jp112sdl/LAWO-FlipDot/PCB/BROSE_LAWO_Adapter/BROSE_LAWO_Adapter.kicad_sch

## KiCad design PCB/BROSE_LAWO_Adapter/BROSE_LAWO_Adapter.kicad_sch (2026-02-11)

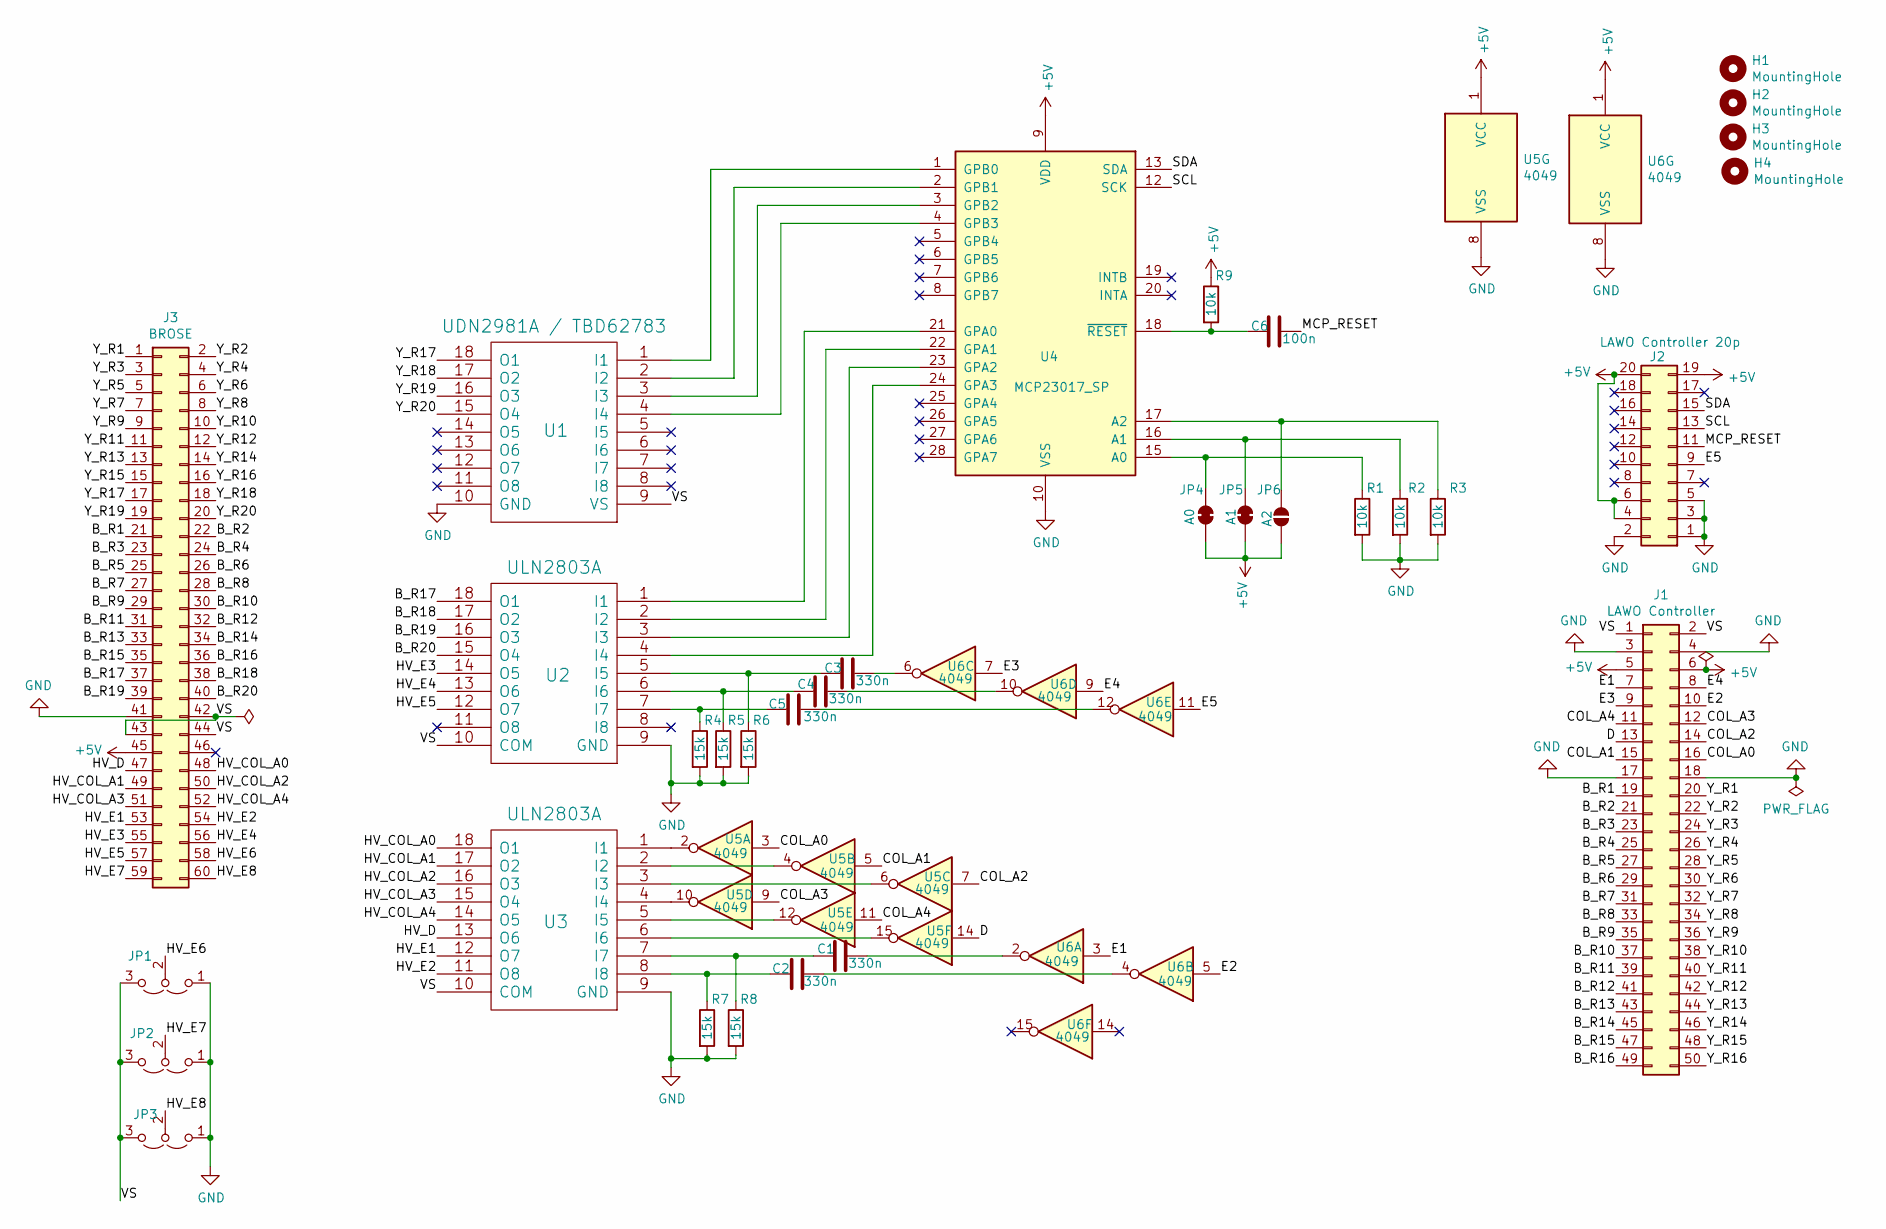
[picture p1: schematic BROSE_LAWO_Adapter.kicad_sch]

Parts:
C1, C2, C3, C4, C5: 330n; C_Rect_L10.0mm_W4.0mm_P7.50mm_MKS4
C6: 100n; C_0805_2012Metric_Pad1.15x1.40mm_HandSolder
H1, H2, H3, H4: MountingHole; 1pin
J1: LAWO Controller; IDC-Header_2x25_P2.54mm_Vertical
J2: LAWO Controller 20p; IDC-Header_2x10_P2.54mm_Vertical
J3: BROSE; IDC-Header_2x30_P2.54mm_Vertical
JP1: E6; PinHeader_1x03_P2.54mm_Vertical
JP2: E7; PinHeader_1x03_P2.54mm_Vertical
JP3: E8; PinHeader_1x03_P2.54mm_Vertical
JP4: A0; SolderJumper-2_P1.3mm_Bridged_RoundedPad1.0x1.5mm
JP5: A1; SolderJumper-2_P1.3mm_Bridged_RoundedPad1.0x1.5mm
JP6: A2; SolderJumper-2_P1.3mm_Open_RoundedPad1.0x1.5mm
R1, R2, R3, R9: 10k; R_0805_2012Metric_Pad1.15x1.40mm_HandSolder
R4, R5, R6, R7, R8: 15k; R_Axial_DIN0204_L3.6mm_D1.6mm_P2.54mm_Vertical
U1: UDN2981A / TBD62783; DIP-18_W7.62mm_Socket
U2, U3: ULN2803A; DIP-18_W7.62mm_Socket
U4: MCP23017_SP; DIP-28_W7.62mm_Socket
U5, U6: 4049; DIP-16_W7.62mm_Socket

Connections:
+5V: J1.5, J1.6, J2.4, J2.6, J2.19, J2.20, J3.45, JP4.2 (B), JP5.2 (B), JP6.2 (B), R9.1, U4.9 (VDD), U5.1 (VCC), U6.1 (VCC)
B_R1: J1.19, J3.21
B_R2: J1.21, J3.22
B_R3: J1.23, J3.23
B_R4: J1.25, J3.24
B_R5: J1.27, J3.25
B_R6: J1.29, J3.26
B_R7: J1.31, J3.27
B_R8: J1.33, J3.28
B_R9: J1.35, J3.29
B_R10: J1.37, J3.30
B_R11: J1.39, J3.31
B_R12: J1.41, J3.32
B_R13: J1.43, J3.33
B_R14: J1.45, J3.34
B_R15: J1.47, J3.35
B_R16: J1.49, J3.36
B_R17: J3.37, U2.18 (O1)
B_R18: J3.38, U2.17 (O2)
B_R19: J3.39, U2.16 (O3)
B_R20: J3.40, U2.15 (O4)
COL_A0: J1.16, U5.3
COL_A1: J1.15, U5.5
COL_A2: J1.14, U5.7
COL_A3: J1.12, U5.9
COL_A4: J1.11, U5.11
D: J1.13, U5.14
E1: J1.7, U6.3
E2: J1.10, U6.5
E3: J1.9, U6.7
E4: J1.8, U6.9
E5: J2.9, U6.11
GND: J1.3, J1.4, J1.17, J1.18, J2.1, J2.2, J2.3, J2.5, J3.41, JP1.1 (A), JP2.1 (A), JP3.1 (A), R1.2, R2.2, R3.2, R4.2, R5.2, R6.2, R7.2, R8.2, U1.10 (GND), U2.9 (GND), U3.9 (GND), U4.10 (VSS), U5.8 (VSS), U6.8 (VSS)
HV_COL_A0: J3.48, U3.18 (O1)
HV_COL_A1: J3.49, U3.17 (O2)
HV_COL_A2: J3.50, U3.16 (O3)
HV_COL_A3: J3.51, U3.15 (O4)
HV_COL_A4: J3.52, U3.14 (O5)
HV_D: J3.47, U3.13 (O6)
HV_E1: J3.53, U3.12 (O7)
HV_E2: J3.54, U3.11 (O8)
HV_E3: J3.55, U2.14 (O5)
HV_E4: J3.56, U2.13 (O6)
HV_E5: J3.57, U2.12 (O7)
HV_E6: J3.58, JP1.2 (C)
HV_E7: J3.59, JP2.2 (C)
HV_E8: J3.60, JP3.2 (C)
MCP_RESET: C6.2, J2.11
unnamed: C1.1, R8.1, U3.7 (I7)
unnamed: C1.2, U6.2
unnamed: C2.1, R7.1, U3.8 (I8)
unnamed: C2.2, U6.4
unnamed: C3.1, R6.1, U2.5 (I5)
unnamed: C3.2, U6.6
unnamed: C4.1, R5.1, U2.6 (I6)
unnamed: C4.2, U6.10
unnamed: C5.1, R4.1, U2.7 (I7)
unnamed: C5.2, U6.12
unnamed: C6.1, R9.2, U4.18 (~RESET)
unnamed: JP4.1 (A), R1.1, U4.15 (A0)
unnamed: JP5.1 (A), R2.1, U4.16 (A1)
unnamed: JP6.1 (A), R3.1, U4.17 (A2)
unnamed: U1.1 (I1), U4.1 (GPB0)
unnamed: U1.2 (I2), U4.2 (GPB1)
unnamed: U1.3 (I3), U4.3 (GPB2)
unnamed: U1.4 (I4), U4.4 (GPB3)
unnamed: U2.1 (I1), U4.21 (GPA0)
unnamed: U2.2 (I2), U4.22 (GPA1)
unnamed: U2.3 (I3), U4.23 (GPA2)
unnamed: U2.4 (I4), U4.24 (GPA3)
unnamed: U3.1 (I1), U5.2
unnamed: U3.2 (I2), U5.4
unnamed: U3.3 (I3), U5.6
unnamed: U3.4 (I4), U5.10
unnamed: U3.5 (I5), U5.12
unnamed: U3.6 (I6), U5.15
SCL: J2.13, U4.12 (SCK)
SDA: J2.15, U4.13 (SDA)
VS: J1.1, J1.2, J3.42, J3.43, J3.44, JP1.3 (B), JP2.3 (B), JP3.3 (B), U1.9 (VS), U2.10 (COM), U3.10 (COM)
Y_R1: J1.20, J3.1
Y_R2: J1.22, J3.2
Y_R3: J1.24, J3.3
Y_R4: J1.26, J3.4
Y_R5: J1.28, J3.5
Y_R6: J1.30, J3.6
Y_R7: J1.32, J3.7
Y_R8: J1.34, J3.8
Y_R9: J1.36, J3.9
Y_R10: J1.38, J3.10
Y_R11: J1.40, J3.11
Y_R12: J1.42, J3.12
Y_R13: J1.44, J3.13
Y_R14: J1.46, J3.14
Y_R15: J1.48, J3.15
Y_R16: J1.50, J3.16
Y_R17: J3.17, U1.18 (O1)
Y_R18: J3.18, U1.17 (O2)
Y_R19: J3.19, U1.16 (O3)
Y_R20: J3.20, U1.15 (O4)
