jp112sdl/LAWO-FlipDot/PCB/LAWO_ESP32/LAWO_ESP32.kicad_sch

## KiCad design PCB/LAWO_ESP32/LAWO_ESP32.kicad_sch (2026-02-11)

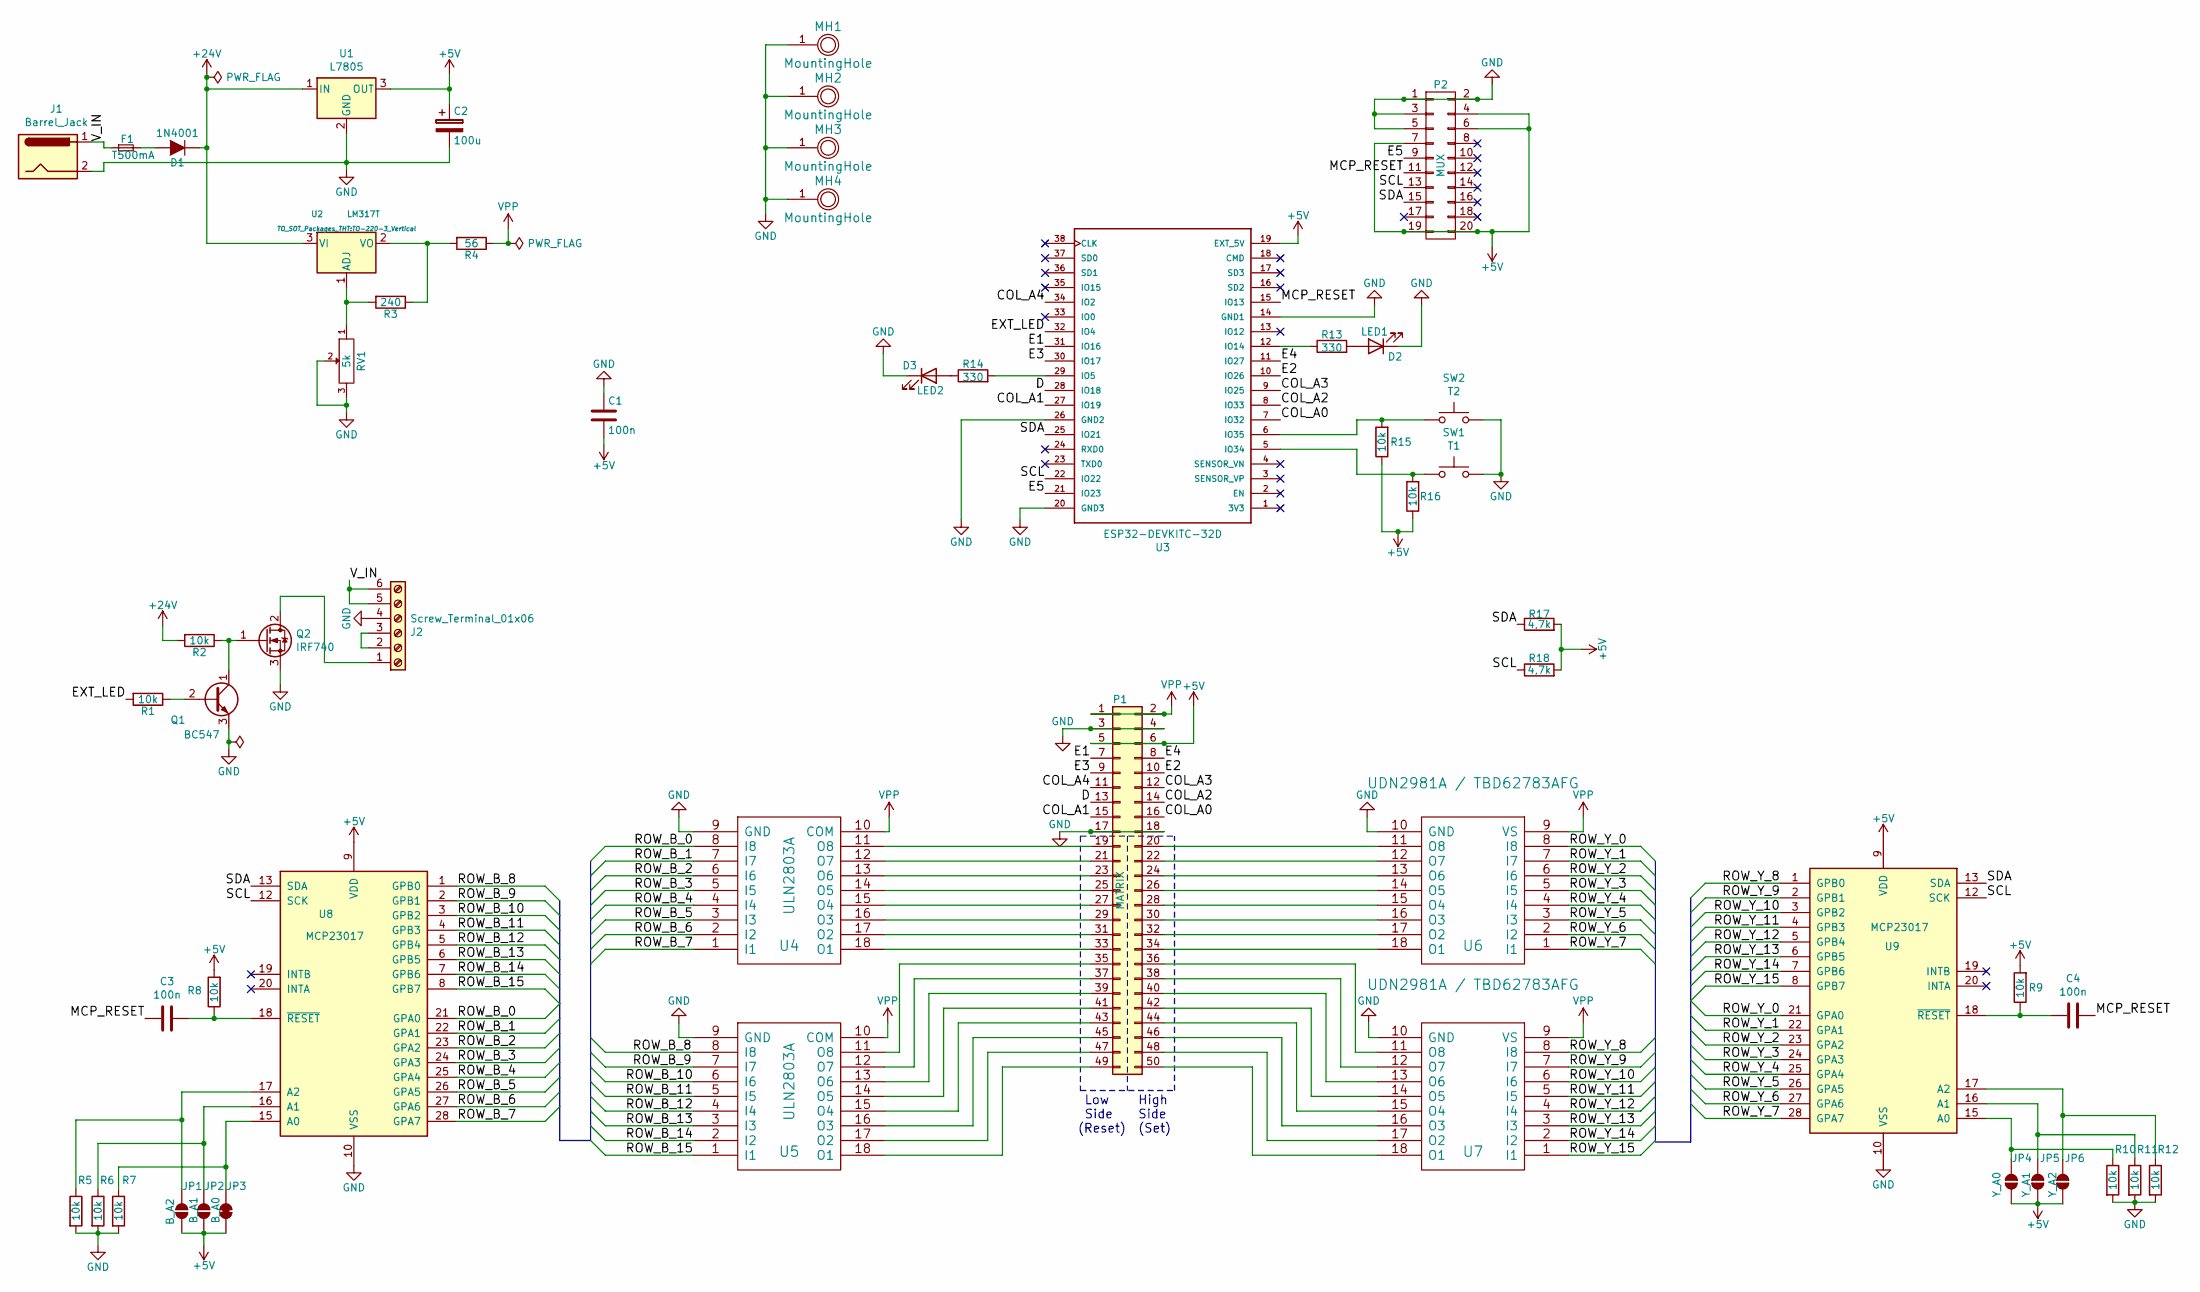
[picture p2: schematic LAWO_ESP32.kicad_sch]

Parts:
C1, C3, C4: 100n; C_0805_2012Metric_Pad1.15x1.40mm_HandSolder
C2: 100u; CP_Radial_D5.0mm_P2.00mm
D1: 1N4001; D_DO-41_SOD81_P10.16mm_Horizontal
D2: LED1; LED_D3.0mm
D3: LED2; LED_D3.0mm
F1: T500mA; Fuseholder5x20_horiz_open_Schurter_0031_8201
J1: Barrel_Jack; BARREL_JACK
J2: Screw_Terminal_01x06; TerminalBlock_bornier-6_P5.08mm
JP1: B_A2; SolderJumper-2_P1.3mm_Open_RoundedPad1.0x1.5mm
JP2: B_A1; SolderJumper-2_P1.3mm_Open_RoundedPad1.0x1.5mm
JP3: B_A0; SolderJumper-2_P1.3mm_Bridged2Bar_RoundedPad1.0x1.5mm
JP4: Y_A0; SolderJumper-2_P1.3mm_Open_RoundedPad1.0x1.5mm
JP5: Y_A1; SolderJumper-2_P1.3mm_Open_RoundedPad1.0x1.5mm
JP6: Y_A2; SolderJumper-2_P1.3mm_Open_RoundedPad1.0x1.5mm
MH1, MH2, MH3, MH4: MountingHole; 1pin
P1: MATRIX; IDC_Header_Straight_50pins
P2: MUX; IDC_Header_Straight_20pins
Q1: BC547; TO-92_HandSolder
Q2: IRF740; TO-220-3_Vertical
R1, R2, R5, R6, R7, R8, R9, R10, R11, R12, R15, R16: 10k; R_0805_2012Metric
R3: 240; R_0805_2012Metric
R4: 56; R_Axial_DIN0411_L9.9mm_D3.6mm_P15.24mm_Horizontal
R13, R14: 330; R_0805_2012Metric
R17, R18: 4,7k; R_0805_2012Metric
RV1: 5k; Potentiometer_Trimmer_Bourns_3299W
SW1: T1; SW_PUSH_6mm_h5mm
SW2: T2; SW_PUSH_6mm_h5mm
U1: L7805; SIP3_11.6x8.5mm
U2: LM317T; TO-220-3_Vertical
U3: ESP32-DEVKITC-32D; MODULE_ESP32-DEVKITC-32D
U4, U5: ULN2803A; DIP-18_W7.62mm_Socket
U6, U7: UDN2981A / TBD62783AFG; DIP-18_W7.62mm_Socket
U8, U9: MCP23017; DIP-28_W7.62mm_Socket

Connections:
+5V: C1.2, C2.1, JP1.2 (B), JP2.2 (B), JP3.2 (B), JP4.2 (B), JP5.2 (B), JP6.2 (B), P1.5, P1.6, P2.4, P2.6, P2.7, P2.19, P2.20, R8.2, R9.2, R15.1, R16.1, R17.2, R18.2, U1.3 (OUT), U3.19 (EXT_5V), U8.9 (VDD), U9.9 (VDD)
+24V: D1.1 (K), R2.2, U1.1 (IN), U2.3 (VI)
COL_A0: P1.16, U3.7 (IO32)
COL_A1: P1.15, U3.27 (IO19)
COL_A2: P1.14, U3.8 (IO33)
COL_A3: P1.12, U3.9 (IO25)
COL_A4: P1.11, U3.34 (IO2)
D: P1.13, U3.28 (IO18)
E1: P1.7, U3.31 (IO16)
E2: P1.10, U3.10 (IO26)
E3: P1.9, U3.30 (IO17)
E4: P1.8, U3.11 (IO27)
E5: P2.9, U3.21 (IO23)
EXT_LED: R1.2, U3.32 (IO4)
GND: C1.1, C2.2, D2.1 (K), D3.1 (K), J1.2, J2.4, MH1.1, MH2.1, MH3.1, MH4.1, P1.3, P1.4, P1.17, P1.18, P2.1, P2.2, P2.3, P2.5, Q1.3 (E), Q2.3 (S), R5.2, R6.2, R7.2, R10.2, R11.2, R12.2, RV1.2, RV1.3, SW1.2, SW2.2, U1.2 (GND), U3.14 (GND1), U3.20 (GND3), U3.26 (GND2), U4.9 (GND), U5.9 (GND), U6.10 (GND), U7.10 (GND), U8.10 (VSS), U9.10 (VSS)
MCP_RESET: C3.2, C4.1, P2.11, U3.15 (IO13)
unnamed: C3.1, R8.1, U8.18 (~RESET)
unnamed: C4.2, R9.1, U9.18 (~RESET)
unnamed: D1.2 (A), F1.2
unnamed: D2.2 (A), R13.2
unnamed: D3.2 (A), R14.1
unnamed: J2.1, Q2.2 (D)
unnamed: J2.2, J2.3
unnamed: JP1.1 (A), R5.1, U8.17 (A2)
unnamed: JP2.1 (A), R6.1, U8.16 (A1)
unnamed: JP3.1 (A), R7.1, U8.15 (A0)
unnamed: JP4.1 (A), R10.1, U9.15 (A0)
unnamed: JP5.1 (A), R11.1, U9.16 (A1)
unnamed: JP6.1 (A), R12.1, U9.17 (A2)
unnamed: P1.19, U4.11 (O8)
unnamed: P1.20, U6.11 (O8)
unnamed: P1.21, U4.12 (O7)
unnamed: P1.22, U6.12 (O7)
unnamed: P1.23, U4.13 (O6)
unnamed: P1.24, U6.13 (O6)
unnamed: P1.25, U4.14 (O5)
unnamed: P1.26, U6.14 (O5)
unnamed: P1.27, U4.15 (O4)
unnamed: P1.28, U6.15 (O4)
unnamed: P1.29, U4.16 (O3)
unnamed: P1.30, U6.16 (O3)
unnamed: P1.31, U4.17 (O2)
unnamed: P1.32, U6.17 (O2)
unnamed: P1.33, U4.18 (O1)
unnamed: P1.34, U6.18 (O1)
unnamed: P1.35, U5.11 (O8)
unnamed: P1.36, U7.11 (O8)
unnamed: P1.37, U5.12 (O7)
unnamed: P1.38, U7.12 (O7)
unnamed: P1.39, U5.13 (O6)
unnamed: P1.40, U7.13 (O6)
unnamed: P1.41, U5.14 (O5)
unnamed: P1.42, U7.14 (O5)
unnamed: P1.43, U5.15 (O4)
unnamed: P1.44, U7.15 (O4)
unnamed: P1.45, U5.16 (O3)
unnamed: P1.46, U7.16 (O3)
unnamed: P1.47, U5.17 (O2)
unnamed: P1.48, U7.17 (O2)
unnamed: P1.49, U5.18 (O1)
unnamed: P1.50, U7.18 (O1)
unnamed: Q1.1 (C), Q2.1 (G), R2.1
unnamed: Q1.2 (B), R1.1
unnamed: R3.1, R4.2, U2.2 (VO)
unnamed: R3.2, RV1.1, U2.1 (ADJ)
unnamed: R13.1, U3.12 (IO14)
unnamed: R14.2, U3.29 (IO5)
unnamed: R15.2, SW2.1, U3.6 (IO35)
unnamed: R16.2, SW1.1, U3.5 (IO34)
ROW_B_0: U4.8 (I8), U8.21 (GPA0)
ROW_B_1: U4.7 (I7), U8.22 (GPA1)
ROW_B_2: U4.6 (I6), U8.23 (GPA2)
ROW_B_3: U4.5 (I5), U8.24 (GPA3)
ROW_B_4: U4.4 (I4), U8.25 (GPA4)
ROW_B_5: U4.3 (I3), U8.26 (GPA5)
ROW_B_6: U4.2 (I2), U8.27 (GPA6)
ROW_B_7: U4.1 (I1), U8.28 (GPA7)
ROW_B_8: U5.8 (I8), U8.1 (GPB0)
ROW_B_9: U5.7 (I7), U8.2 (GPB1)
ROW_B_10: U5.6 (I6), U8.3 (GPB2)
ROW_B_11: U5.5 (I5), U8.4 (GPB3)
ROW_B_12: U5.4 (I4), U8.5 (GPB4)
ROW_B_13: U5.3 (I3), U8.6 (GPB5)
ROW_B_14: U5.2 (I2), U8.7 (GPB6)
ROW_B_15: U5.1 (I1), U8.8 (GPB7)
ROW_Y_0: U6.8 (I8), U9.21 (GPA0)
ROW_Y_1: U6.7 (I7), U9.22 (GPA1)
ROW_Y_2: U6.6 (I6), U9.23 (GPA2)
ROW_Y_3: U6.5 (I5), U9.24 (GPA3)
ROW_Y_4: U6.4 (I4), U9.25 (GPA4)
ROW_Y_5: U6.3 (I3), U9.26 (GPA5)
ROW_Y_6: U6.2 (I2), U9.27 (GPA6)
ROW_Y_7: U6.1 (I1), U9.28 (GPA7)
ROW_Y_8: U7.8 (I8), U9.1 (GPB0)
ROW_Y_9: U7.7 (I7), U9.2 (GPB1)
ROW_Y_10: U7.6 (I6), U9.3 (GPB2)
ROW_Y_11: U7.5 (I5), U9.4 (GPB3)
ROW_Y_12: U7.4 (I4), U9.5 (GPB4)
ROW_Y_13: U7.3 (I3), U9.6 (GPB5)
ROW_Y_14: U7.2 (I2), U9.7 (GPB6)
ROW_Y_15: U7.1 (I1), U9.8 (GPB7)
SCL: P2.13, R18.1, U3.22 (IO22), U8.12 (SCK), U9.12 (SCK)
SDA: P2.15, R17.1, U3.25 (IO21), U8.13 (SDA), U9.13 (SDA)
VPP: P1.1, P1.2, R4.1, U4.10 (COM), U5.10 (COM), U6.9 (VS), U7.9 (VS)
V_IN: F1.1, J1.1, J2.5, J2.6

Notes on the sheet:
High Side (Set)
Low Side (Reset)
