jp112sdl/LAWO-FlipDot/(commit log)

2022-03-23 update pcb
2026-02-11 update pcb files
    [BROSE_LAWO_Adapter.kicad_sch, LAWO_ESP32.kicad_sch]
